mmarco-sirt/OrnitoSIRT/capturas/pantallas_1.png

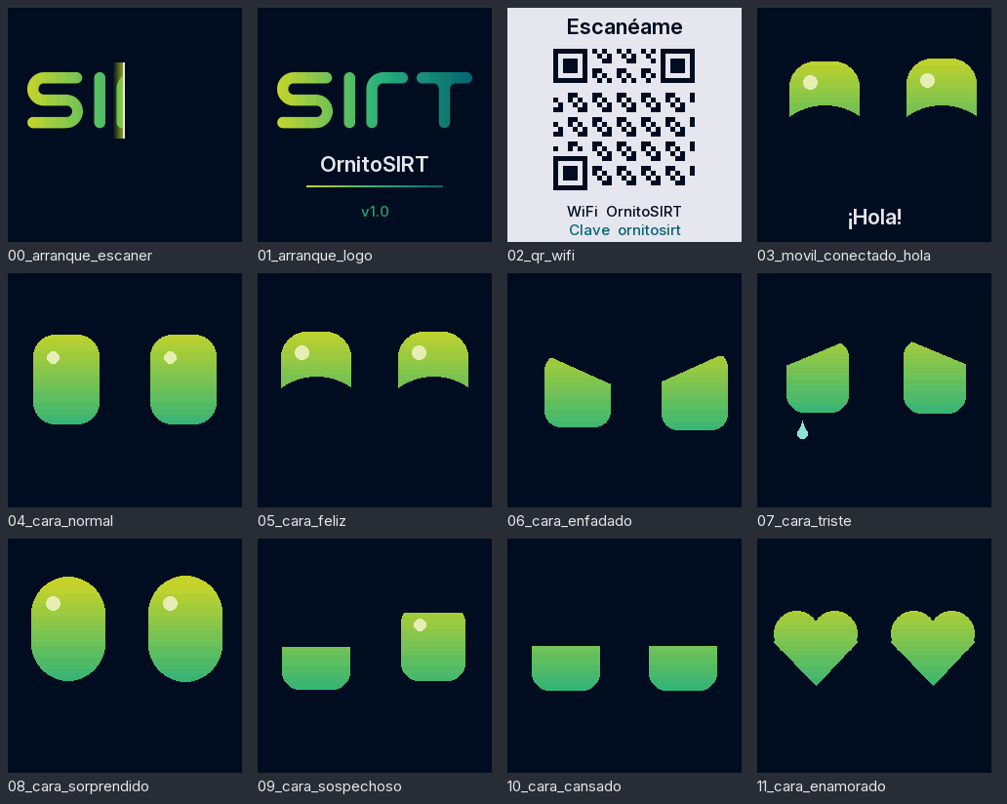
capturas/pantallas_1.png
