mmarco-sirt/OrnitoSIRT/capturas/pantallas_2.png

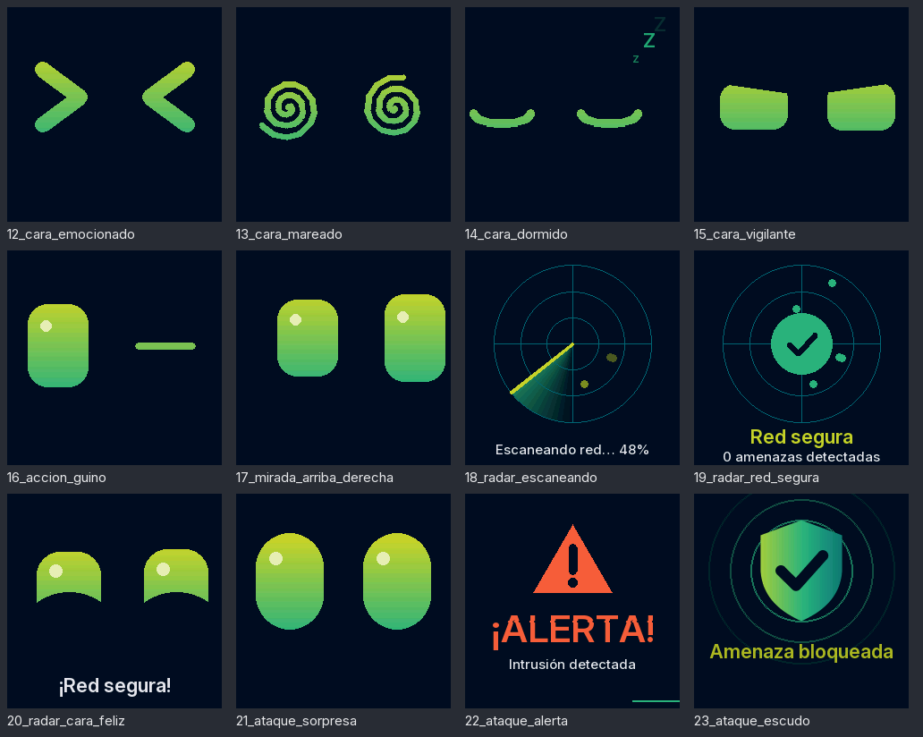
capturas/pantallas_2.png
