mmarco-sirt/OrnitoSIRT/capturas/pantallas_3.png

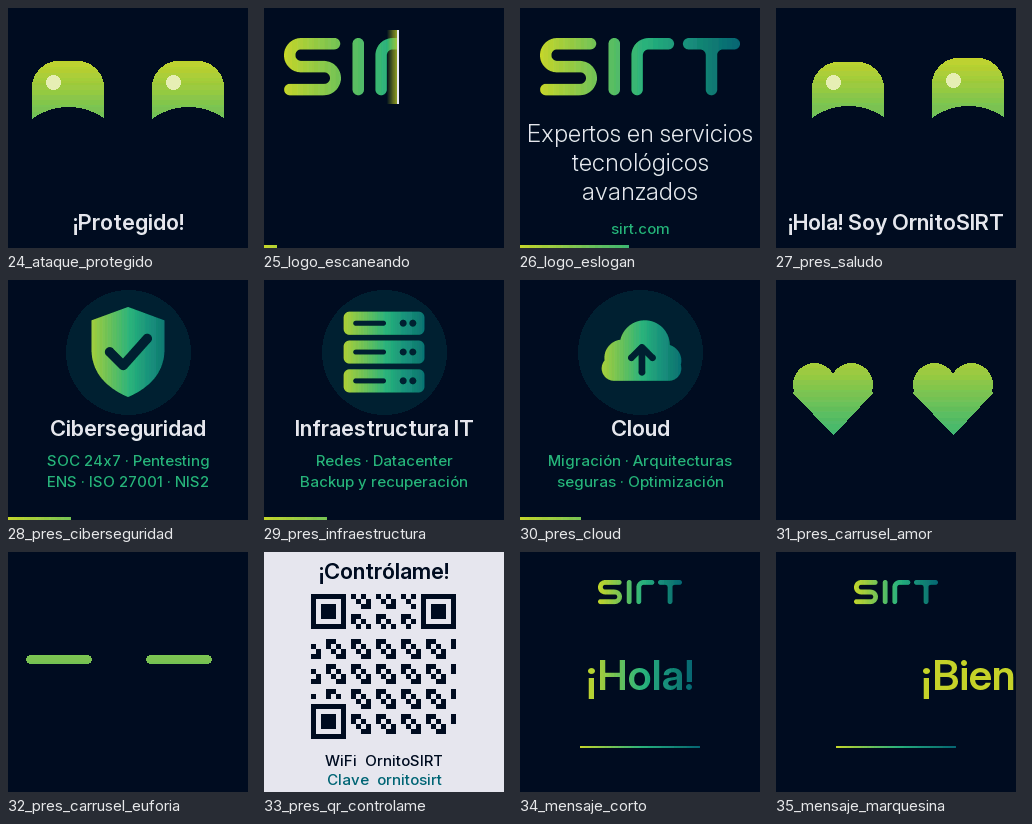
capturas/pantallas_3.png
