mmarco-sirt/OrnitoSIRT/capturas/pantallas_4.png

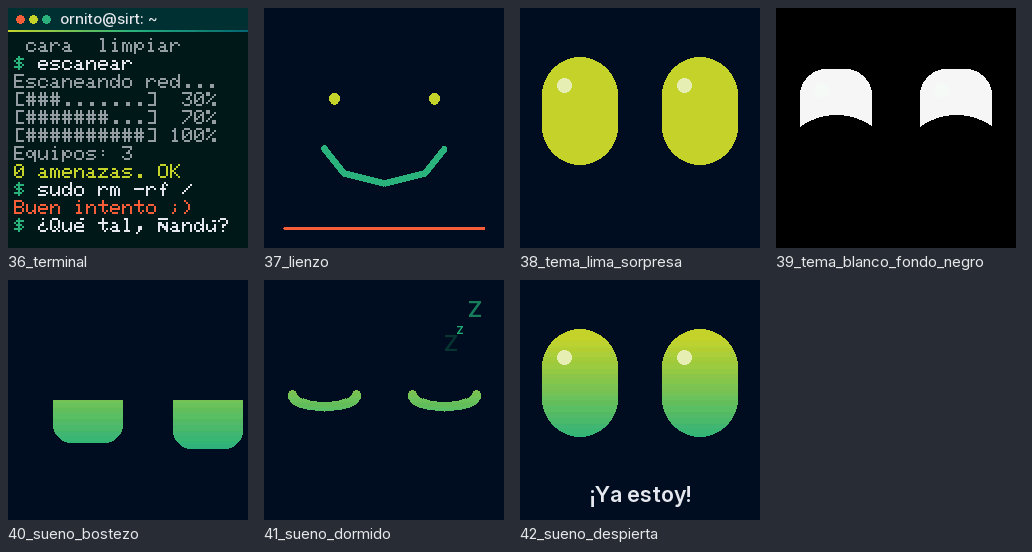
capturas/pantallas_4.png
