mmarco-sirt/OrnitoSIRT/hardware/cubo_pantalla_1-3/vistas/carcasa.png

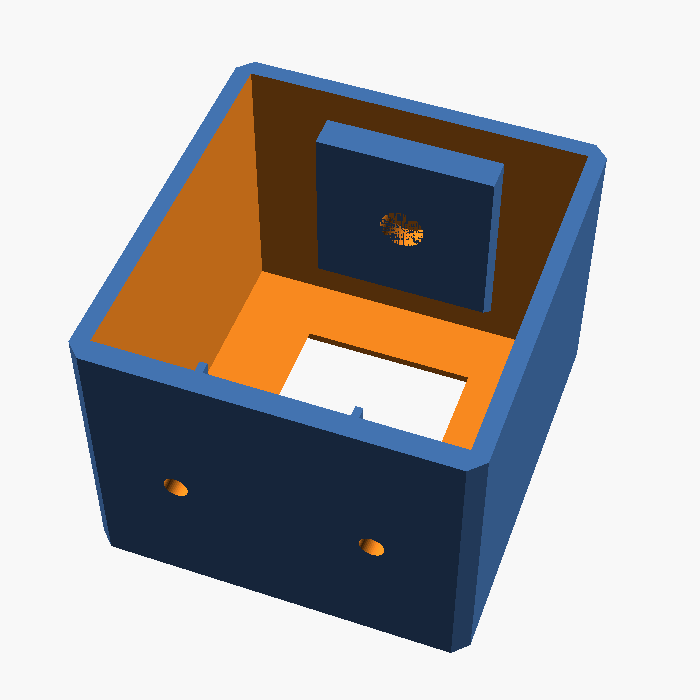
hardware/cubo_pantalla_1-3/vistas/carcasa.png
