mmarco-sirt/OrnitoSIRT/hardware/cubo_pantalla_1-3/vistas/frontal.png

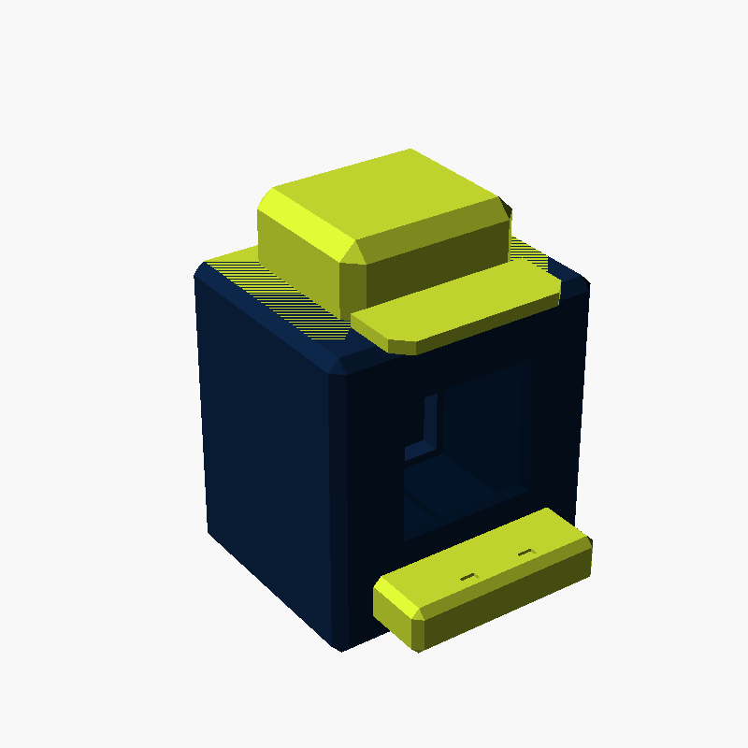
hardware/cubo_pantalla_1-3/vistas/frontal.png
