mmarco-sirt/OrnitoSIRT/hardware/cubo_pantalla_1-3/vistas/trasera.png

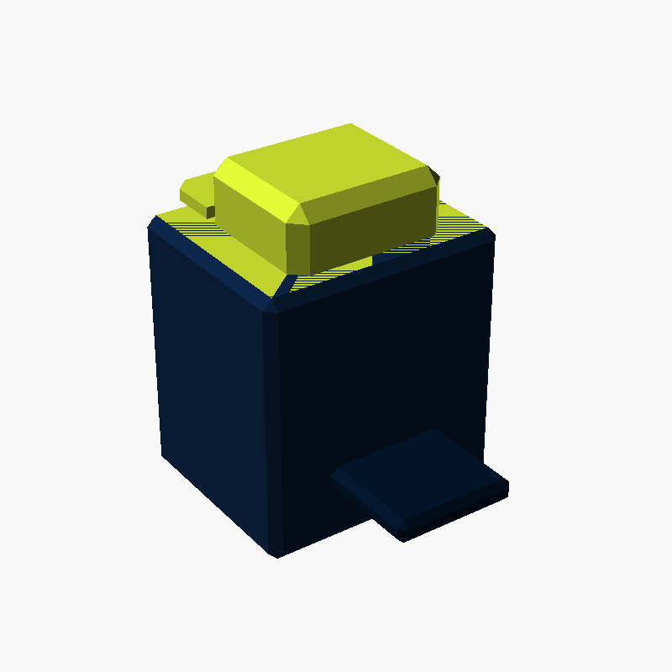
hardware/cubo_pantalla_1-3/vistas/trasera.png
