mmarco-sirt/OrnitoSIRT/hardware/cubo_pantalla_1-54/vistas/vista_tapon.png

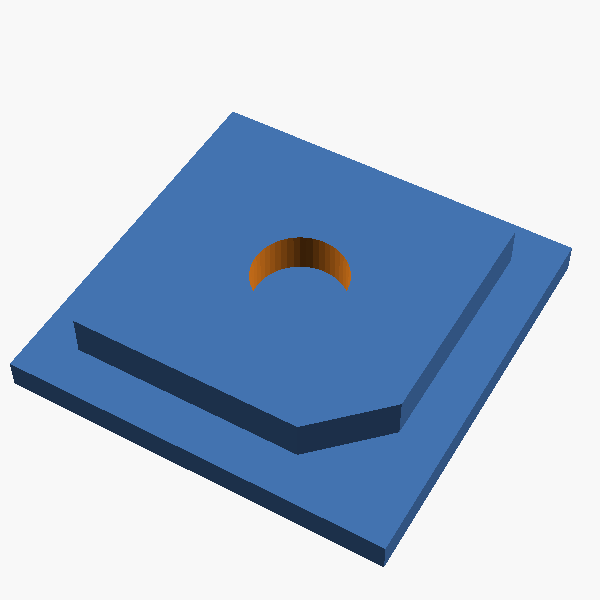
hardware/cubo_pantalla_1-54/vistas/vista_tapon.png
