mmarco-sirt/OrnitoSIRT/hardware/cubo_pantalla_1-3/stl/gorra.stl

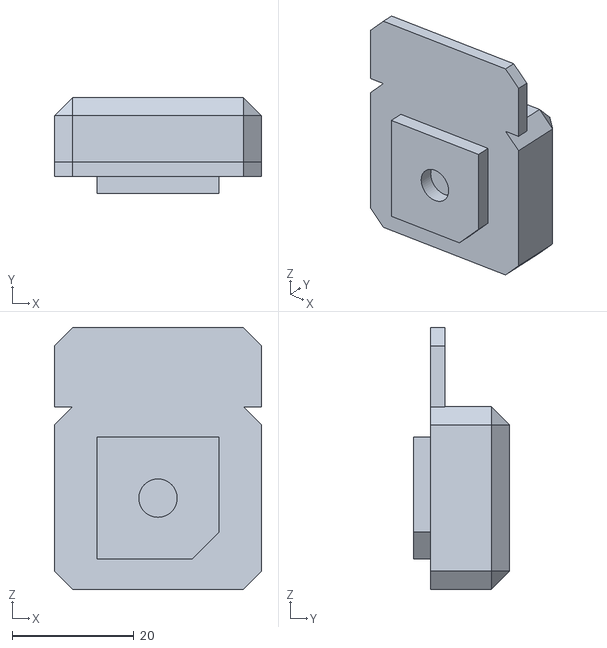
[picture p9: CAD file, 2026-10-26]
hardware/cubo_pantalla_1-3/stl/gorra.stl
34.0 x 15.8 x 43.0
