mmarco-sirt/OrnitoSIRT/hardware/cubo_pantalla_1-54/stl/base_accesorio.stl

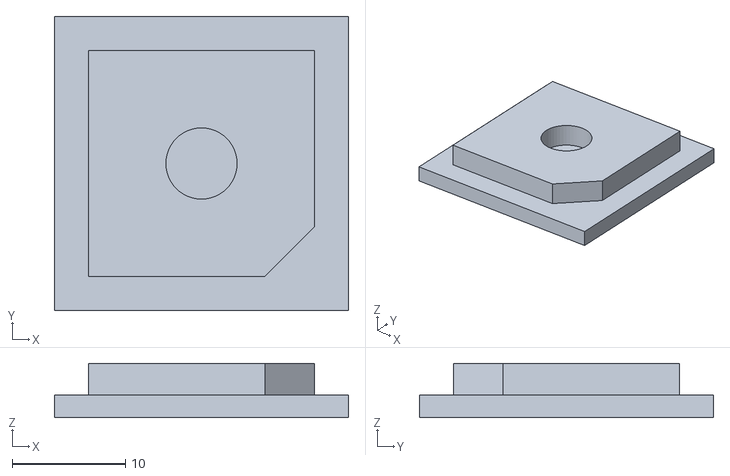
[picture p10: CAD file, 2026-10-26]
hardware/cubo_pantalla_1-54/stl/base_accesorio.stl
26.0 x 26.0 x 4.80
