mmarco-sirt/OrnitoSIRT/hardware/cubo_pantalla_1-3/stl/tapa_trasera.stl

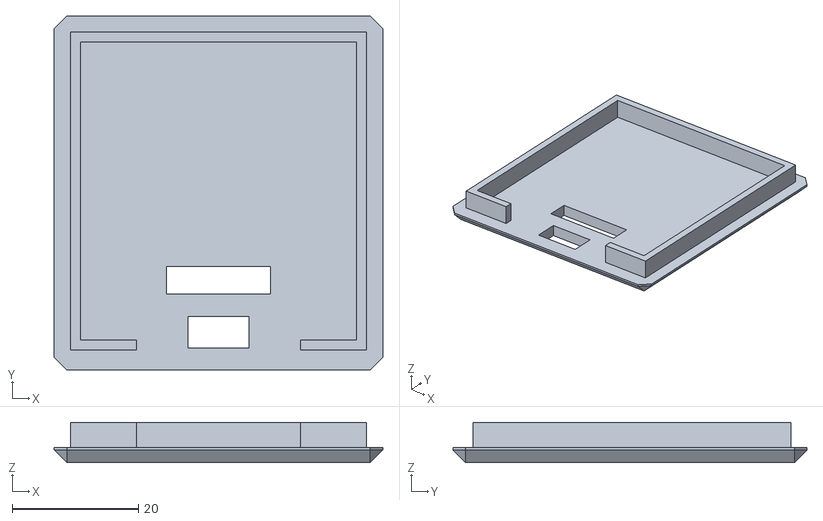
[picture p11: CAD file, 2026-10-26]
hardware/cubo_pantalla_1-3/stl/tapa_trasera.stl
52.0 x 56.0 x 6.40
