mmarco-sirt/OrnitoSIRT/hardware/cubo_pantalla_1-3/stl/patas.stl

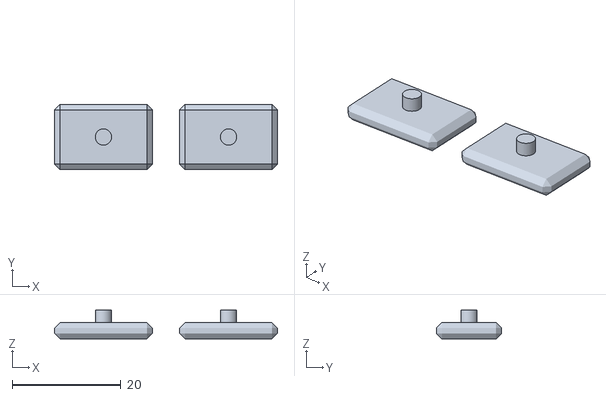
[picture p12: CAD file, 2026-10-26]
hardware/cubo_pantalla_1-3/stl/patas.stl
41.0 x 12.0 x 5.29
