mmarco-sirt/OrnitoSIRT/hardware/cubo_pantalla_1-3/stl/prueba_encaje.stl

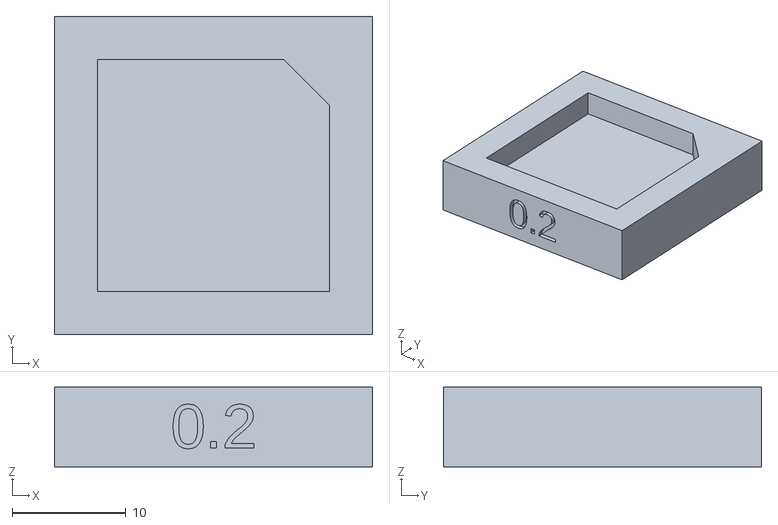
[picture p13: CAD file, 2026-10-26]
hardware/cubo_pantalla_1-3/stl/prueba_encaje.stl
28.0 x 28.0 x 7.00
