mmarco-sirt/OrnitoSIRT/hardware/cubo_pantalla_1-3/stl/pico.stl

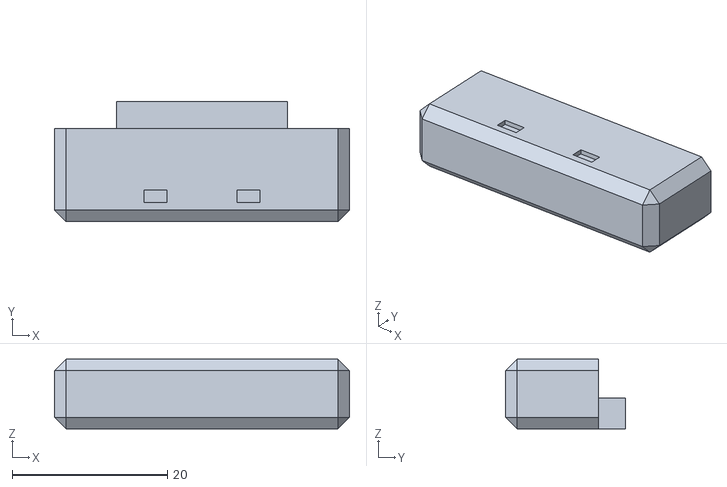
[picture p14: CAD file, 2026-10-26]
hardware/cubo_pantalla_1-3/stl/pico.stl
38.0 x 15.5 x 9.00
