mmarco-sirt/OrnitoSIRT/hardware/cubo_pantalla_1-3/stl/carcasa.stl

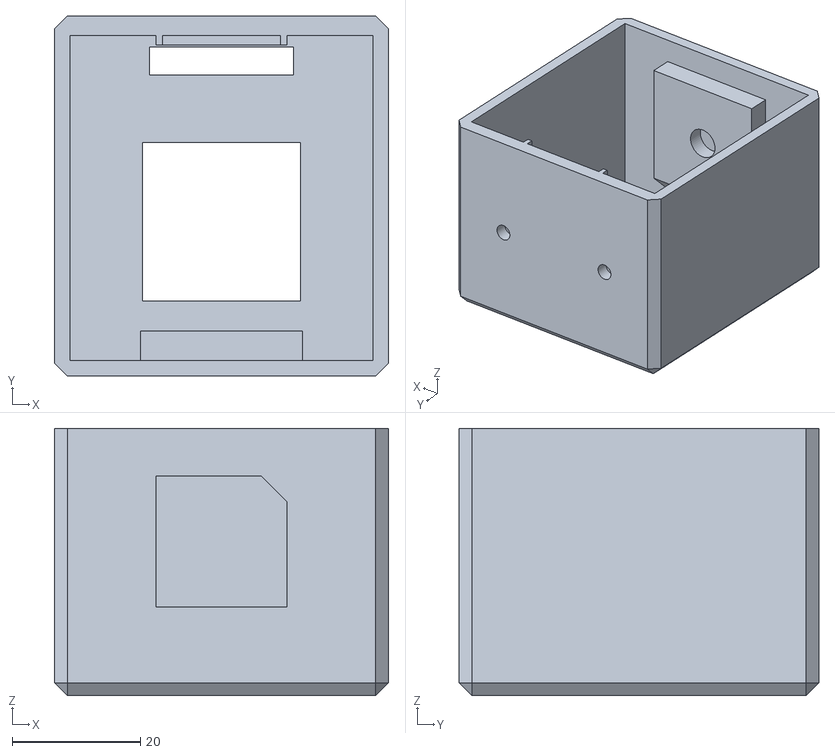
[picture p15: CAD file, 2026-10-26]
hardware/cubo_pantalla_1-3/stl/carcasa.stl
52.0 x 56.0 x 41.6
