mmarco-sirt/OrnitoSIRT/hardware/cubo_pantalla_1-3/stl/cola.stl

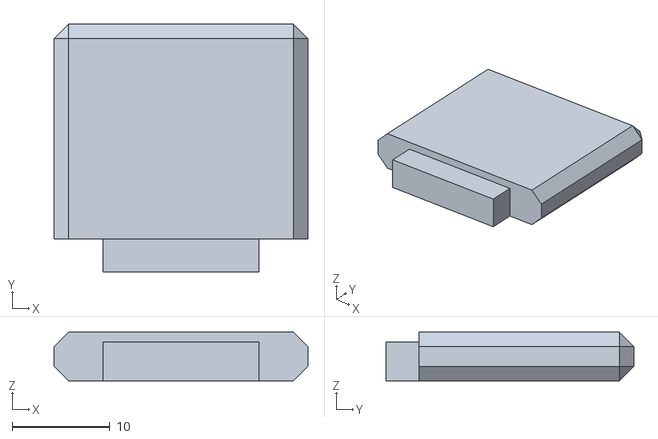
[picture p17: CAD file, 2026-10-26]
hardware/cubo_pantalla_1-3/stl/cola.stl
26.0 x 25.4 x 5.00
