mmarco-sirt/OrnitoSIRT/(list of files, cad)

Other CAD files:
hardware/cubo_pantalla_1-54/stl/gorra.stl
hardware/cubo_pantalla_1-54/cubo.scad
