mmarco-sirt/OrnitoSIRT/firmware/OrnitoSIRT/recursos.h

// ═══════════════════════════════════════════════════════════════════
//  recursos.h · GENERADO por herramientas/generar_recursos.py
//  No editar a mano: cambia el script y vuelve a ejecutarlo.
//  Tipografía Inter (SIL Open Font License 1.1) · Logo © SIRT
// ═══════════════════════════════════════════════════════════════════
#pragma once
#include <stdint.h>
#include <pgmspace.h>

// Mapas de transparencia de 4 bits (2 píxeles por byte, nibble alto primero)
typedef struct { uint16_t cp; uint32_t off; uint8_t w, h; int8_t dx, dy; uint8_t avance; } GlifoAA;
typedef struct { const uint8_t *bits; const GlifoAA *glifos; uint16_t n; uint8_t ascenso, alto; } FuenteAA;
typedef struct { const uint8_t *bits; uint16_t w, h; } ImagenAA;

static const uint8_t LOGO_GRANDE_BITS[] PROGMEM = {
  0x00,0x00,0x00,0x00,0x00,0x01,0x5A,0xCD,0xFF,0xFF,0xFF,0xFF,0xFF,0xFF,0xFF,0xFF,0xFF,0xFF,0xFF,0xFF,0xFF,0xFF,0xFF,0xFF,
  0xFF,0xFF,0xA3,0x00,0x00,0x00,0x00,0x00,0x00,0x00,0x00,0x05,0xBF,0xFE,0x91,0x00,0x00,0x00,0x00,0x00,0x00,0x00,0x00,0x00,
  0x00,0x00,0x00,0x02,0x7A,0xDE,0xFF,0xFF,0xFF,0xFF,0xFF,0xFF,0xFF,0xFF,0xFF,0xFF,0xFE,0x91,0x00,0x00,0x00,0x00,0x00,0x00,
  0x01,0x7D,0xFF,0xFF,0xFF,0xFF,0xFF,0xFF,0xFF,0xFF,0xFF,0xFF,0xFF,0xFF,0xFF,0xFF,0xFF,0xFF,0xFF,0xFF,0xFF,0xFF,0xFF,0xFF,
  0xFF,0xFC,0x71,0x00,0x00,0x00,0x00,0x00,0x03,0x9F,0xFF,0xFF,0xFF,0xFF,0xFF,0xFF,0xFF,0xFF,0xFF,0xFF,0xFF,0xFF,0xFF,0xFF,
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
  {0x0042,8726,23,30,3,-30,27},
  {0x0043,9071,28,30,1,-30,30},
  {0x0044,9491,26,30,3,-30,30},
  {0x0045,9881,21,30,3,-30,25},
  {0x0046,10196,21,30,3,-30,24},
  {0x0047,10511,28,30,1,-30,31},
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
};

static const FuenteAA F_GRANDE = { F_GRANDE_BITS, F_GRANDE_GLIFOS, 125, 41, 52 };
