mmarco-sirt/OrnitoSIRT/(commit log)

2026-10-26 OrnitoSIRT v1.0: mascota de SIRT para ESP32-C3 y pantalla 1,3"
    Firmware nuevo basado en clawd-mochi (MIT), adaptado a la imagen de SIRT:
    - 12 expresiones, acciones y vida propia (parpadeo, miradas, sueño)
    - Demos: modo presentación, radar del SOC y ataque simulado
    - Panel web en el móvil con portal cautivo y QR de conexión
    - Mensajes, terminal y lienzo; ajustes guardados en NVS
    - Paleta, logo y tipografía Inter de sirt.com, con tildes y ñ
    - Framebuffer en franjas para pintar sin parpadeos en el ESP32-C3
    - Binario listo para cargar y script cargar_firmware.bat
    [base_accesorio.stl, carcasa.stl, cola.stl, cubo.scad, gorra.stl, patas.stl, pico.stl, prueba_encaje.stl]
2026-10-26 Renombra LEEME.md a README.md para que GitHub lo muestre
    Actualiza también las referencias en el propio README y en cargar_firmware.bat.
2026-10-26 Renombra los LEEME.md de hardware a README.md
    Así GitHub muestra la documentación al entrar en cada carpeta de carcasa.
